cnlohr/magfestbadges/README.md

magfestbadges
=============

The codebase, schematics, etc. of the MAGFest Badges.
