cnlohr/magfestbadges/hardware/BoardAndTop.pdf

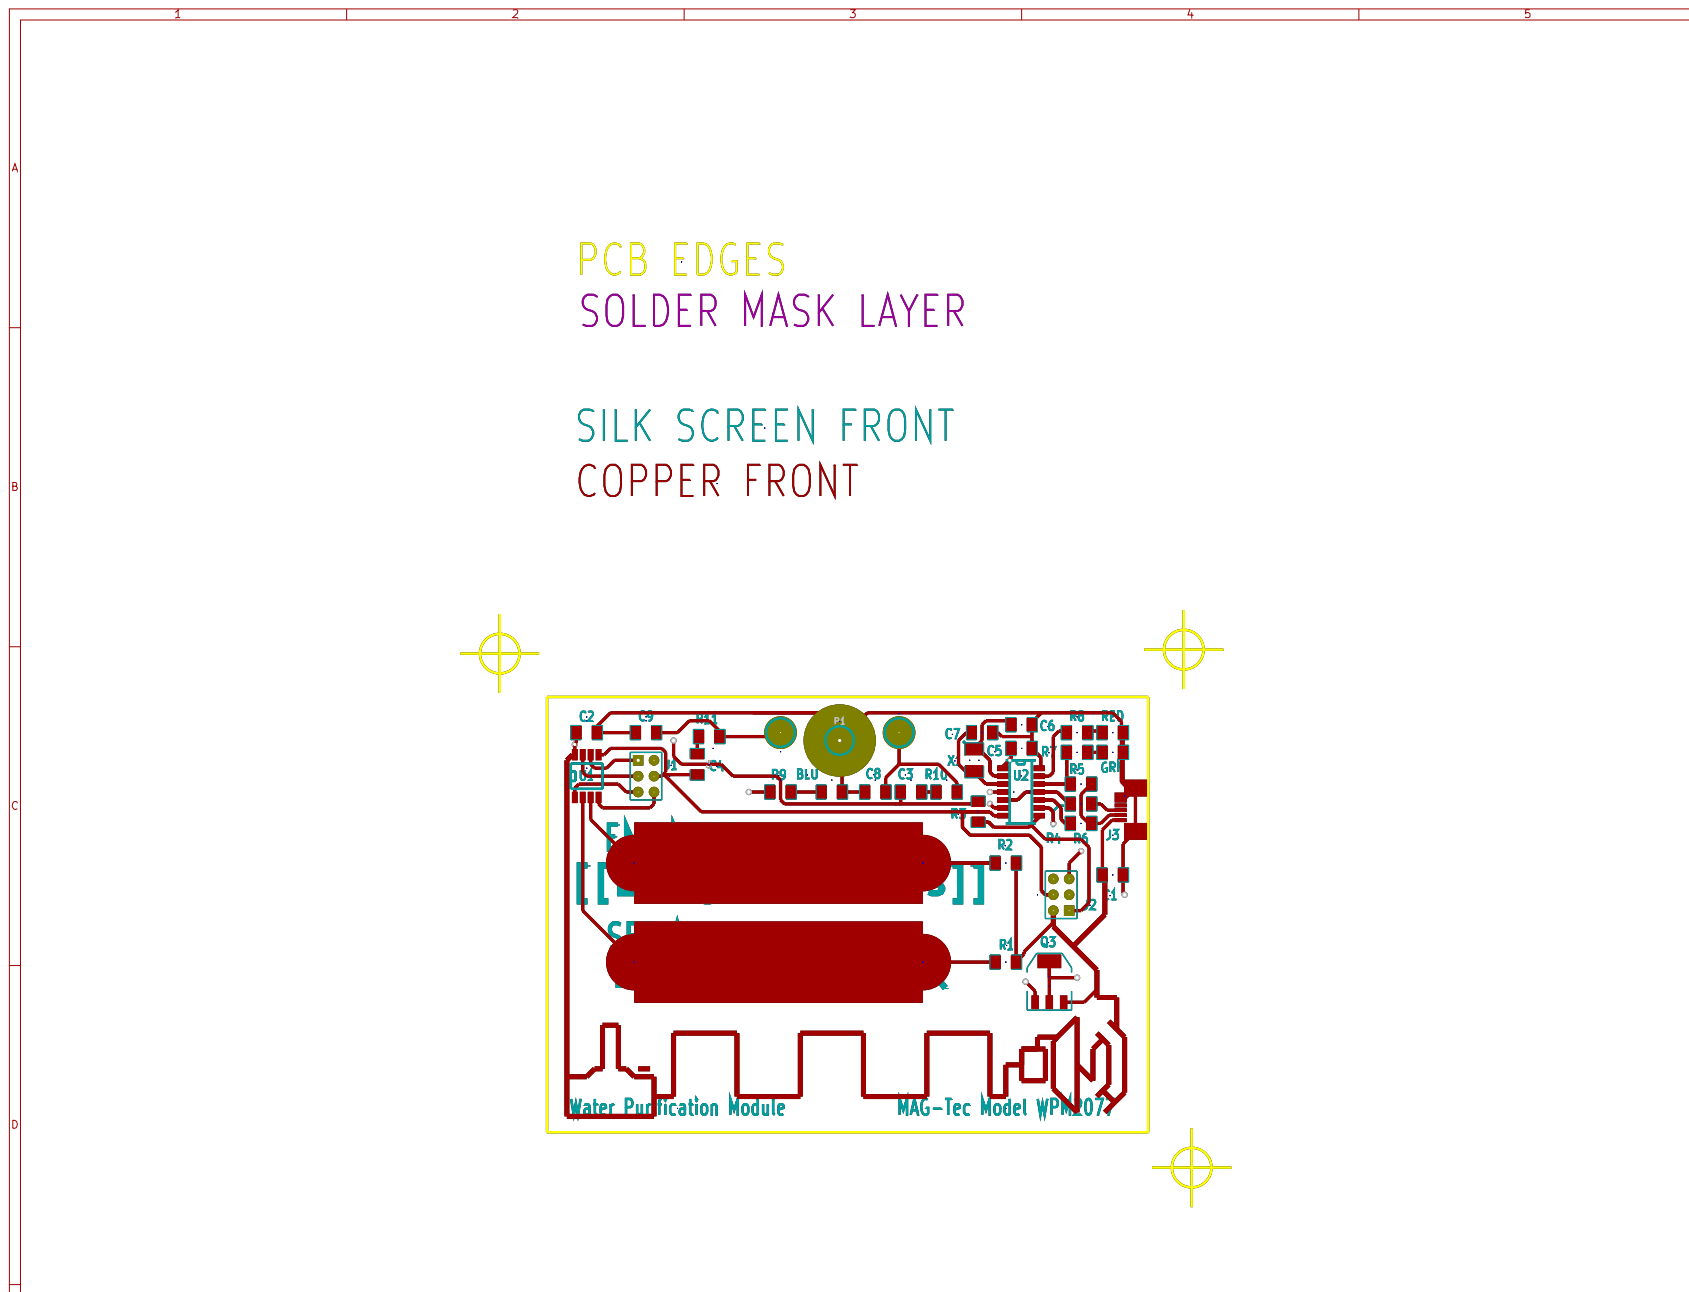
[picture p1: page 1]
