cnlohr/magfestbadges/hardware/schematic.pdf

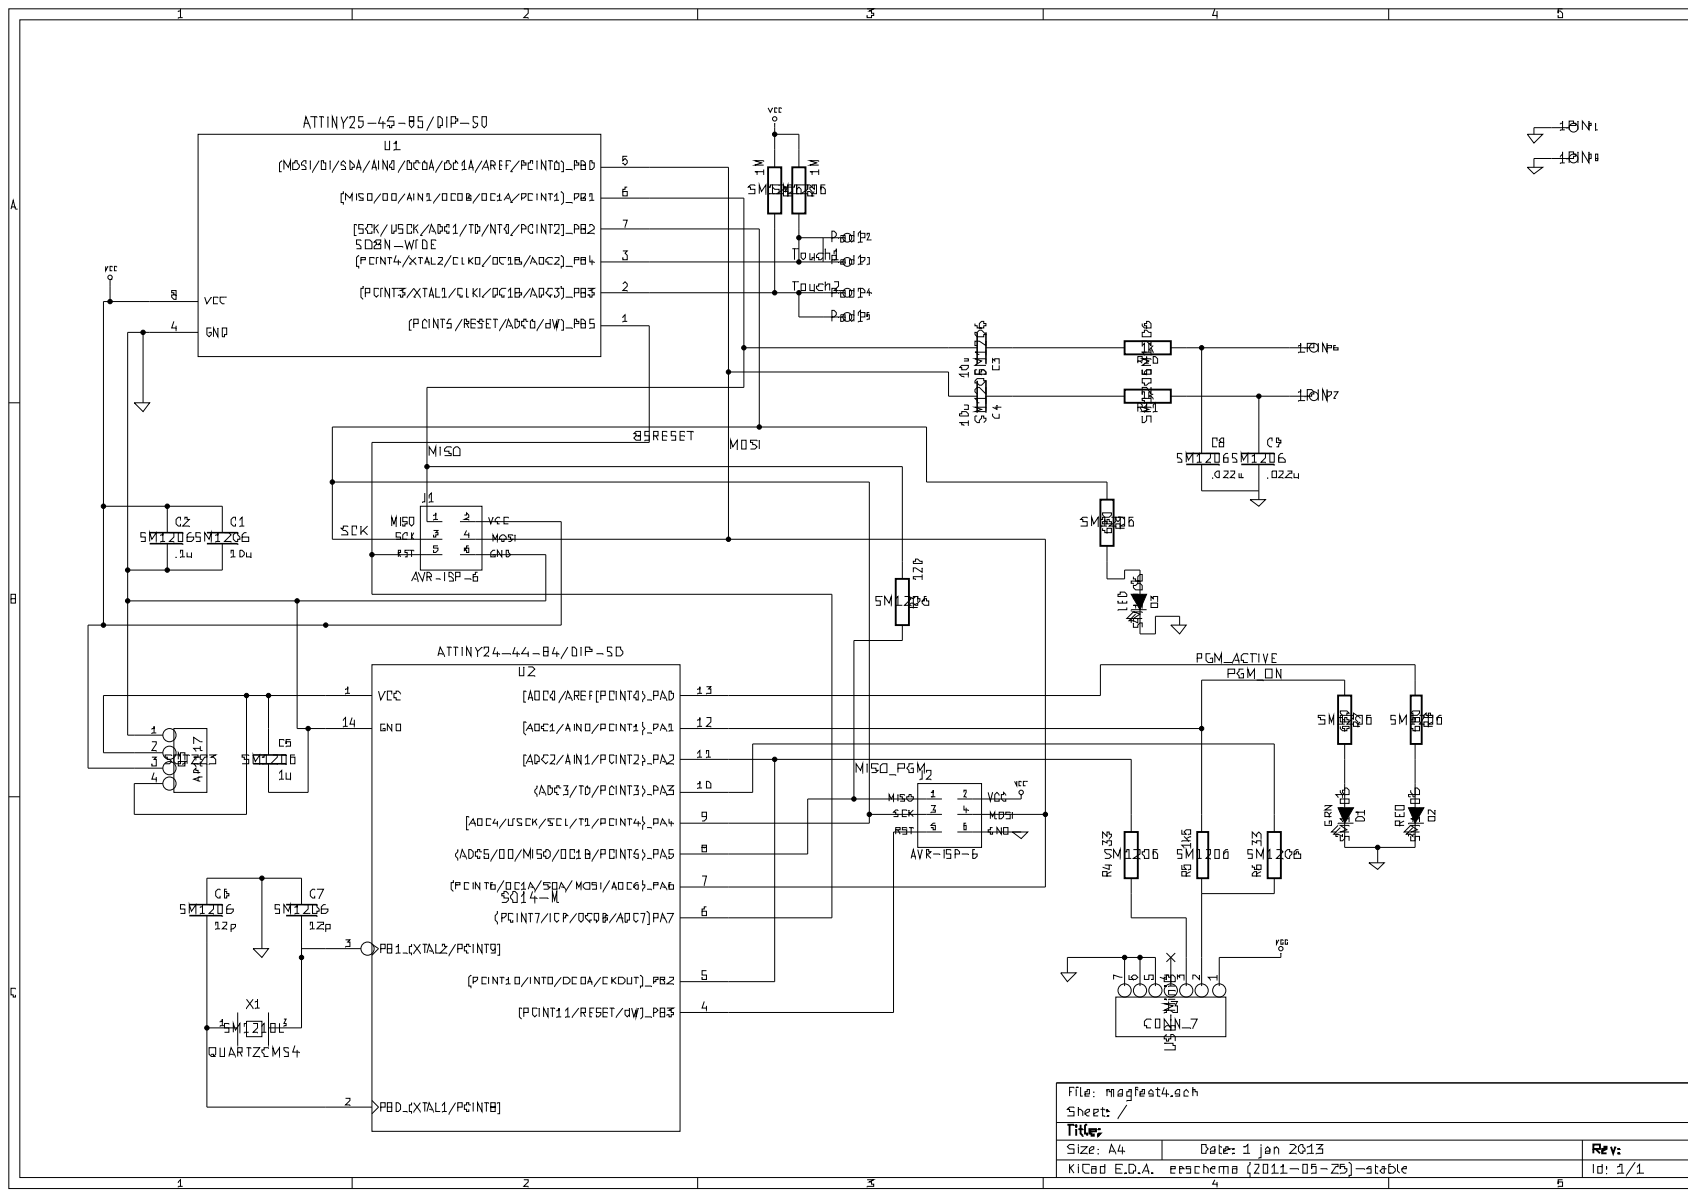
[picture p2: page 1]
