cnlohr/magfestbadges/hardware/magfest4.sch

## KiCad design hardware/magfest4.sch (2013-01-05)

Schematic: magfest4.sch

Parts:
C1, C3, C4: 10u; SM1206
C2: .1u; SM1206
C5: 1u; SM1206
C6, C7: 12p; SM1206
C8, C9: .022u; SM1206
D1: GRN; SM1206
D2: RED; SM1206
D3: LED; SM1206
J1, J2: AVR-ISP-6; pin_array_3x2
J3: CONN_7; USB-MiniB
P1, P6, P7, P8: CONN_1; 1PIN
P2, P3, P4, P5: CONN_1; Pad1
Q3: AP1117; SOT223
R1, R2: 1M; SM1206
R3: 120; SM1206
R4, R6: 33; SM1206
R5: 1k5; SM1206
R7, R8, R9: 680; SM1206
R10, R11: 1k; SM1206
U1: ATTINY25-45-85/DIP-SO; SO8N-WIDE
U2: ATTINY24-44-84/DIP-SO; SO14-M
X1: QUARTZCMS4; SM1210L
