cnlohr/magfestbadges/programmerfw/spi/main.c

// ======================================================================
// Control a parallel port AVR programmer (avrdude type "bsd") via USB.
//
// Copyright (C) 2006 Dick Streefland
//
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
#include <avr/io.h>
#include "usb.h"

enum
{
	// Generic requests
	USBTINY_ECHO,		// echo test
	USBTINY_READ,		// read byte
	USBTINY_WRITE,		// write byte
	USBTINY_CLR,		// clear bit 
	USBTINY_SET,		// set bit
	// Programming requests
	USBTINY_POWERUP,	// apply power (wValue:SCK-period, wIndex:RESET)
	USBTINY_POWERDOWN,	// remove power from chip
	USBTINY_SPI,		// issue SPI command (wValue:c1c0, wIndex:c3c2)
	USBTINY_POLL_BYTES,	// set poll bytes for write (wValue:p1p2)
	USBTINY_FLASH_READ,	// read flash (wIndex:address)
	USBTINY_FLASH_WRITE,	// write flash (wIndex:address, wValue:timeout)
	USBTINY_EEPROM_READ,	// read eeprom (wIndex:address)
	USBTINY_EEPROM_WRITE,	// write eeprom (wIndex:address, wValue:timeout)
	USBTINY_DDRWRITE,        // set port direction
	USBTINY_SPI1            // a single SPI command
};

// ----------------------------------------------------------------------
// Programmer output pins:
//	LED	PB0	(D0)
#define LED PA0
#define POWER_PULLUP	PA1
//	VCC	PB1	(D1)
//	VCC	PB2	(D2)
//	VCC	PB3	(D3)
//	RESET	PB5	(D4)
#define RESET PA7
//	MOSI	PB5	(D5)
#define MOSI  PA6
//	SCK	PB7	(D7)
#define SCK   PA4

// ----------------------------------------------------------------------
#define	PORT		PORTA
#define	DDR		DDRA
#define	POWER_MASK	_BV(POWER_PULLUP)
#define	RESET_MASK	_BV(RESET)
#define	SCK_MASK	_BV(SCK)
#define	MOSI_MASK	_BV(MOSI)
#define LED_MASK        _BV(LED)

// ----------------------------------------------------------------------
// Programmer input pins:
//	MISO	PA6
#define MISO       5
// ----------------------------------------------------------------------
#define	PIN		PINA
#define	MISO_MASK	_BV(MISO)

// ----------------------------------------------------------------------
// Local data
// ----------------------------------------------------------------------
static	byte_t		sck_period;	// SCK period in microseconds (1..250)
static	byte_t		poll1;		// first poll byte for write
static	byte_t		poll2;		// second poll byte for write
static	uint_t		address;	// read/write address
static	uint_t		timeout;	// write timeout in usec
static	byte_t		cmd0;		// current read/write command byte
static	byte_t		cmd[4];		// SPI command buffer
static	byte_t		res[4];		// SPI result buffer

// ----------------------------------------------------------------------
// Delay exactly <sck_period> times 0.5 microseconds (6 cycles).
// ----------------------------------------------------------------------
__attribute__((always_inline))
static	void	delay ( void )
{
	asm volatile(
		"	mov	__tmp_reg__,%0	\n"
		"0:	rjmp	1f		\n"
		"1:	nop			\n"
		"	dec	__tmp_reg__	\n"
		"	brne	0b		\n"
		: : "r" (sck_period) );
}

// ----------------------------------------------------------------------
// Issue one SPI command.
// ----------------------------------------------------------------------
static	void	spi ( byte_t* cmd, byte_t* res, int i )
{
	byte_t	c;
	byte_t	r;
	byte_t	mask;

	while (i != 0)
	{
	  i--;
		c = *cmd++;
		r = 0;
		for	( mask = 0x80; mask; mask >>= 1 )
		{
			if	( c & mask )
			{
				PORT |= MOSI_MASK;
			}
			delay();
			PORT |= SCK_MASK;
			delay();
			r <<= 1;
			if	( PIN & MISO_MASK )
			{
				r++;
			}
			PORT &= ~ MOSI_MASK;
			PORT &= ~ SCK_MASK;
		}
		*res++ = r;
	}
}

// ----------------------------------------------------------------------
// Create and issue a read or write SPI command.
// ----------------------------------------------------------------------
static	void	spi_rw ( void )
{
	uint_t	a;

	a = address++;
	if	( cmd0 & 0x80 )
	{	// eeprom
		a <<= 1;
	}
	cmd[0] = cmd0;
	if	( a & 1 )
	{
		cmd[0] |= 0x08;
	}
	cmd[1] = a >> 9;
	cmd[2] = a >> 1;
	spi( cmd, res, 4 );
}

unsigned char micro_remap_mask( unsigned char c )
{
	unsigned char outmask = POWER_MASK;
	if( c & 1 )	outmask |= LED_MASK;
	if( c & 16 )	outmask |= RESET_MASK;
	if( c & 32 )	outmask |= MOSI_MASK;
	if( c & 64 )	outmask |= MISO_MASK;
	if( c & 128 )	outmask |= SCK_MASK;
	return outmask;
}

// ----------------------------------------------------------------------
// Handle a non-standard SETUP packet.
// ----------------------------------------------------------------------
extern	byte_t	usb_setup ( byte_t data[8] )
{
	byte_t	bit;
	byte_t	mask;
	byte_t*	addr;
	byte_t	req;

	// Generic requests
	req = data[1];
	if	( req == USBTINY_ECHO )
	{
		return 8;
	}
	addr = (byte_t*) (int) data[4];
	bit = data[2] & 7;

	mask = 1 << bit;
	if (req == USBTINY_SET) {
	  mask = micro_remap_mask( mask );
	  PORT |= mask | POWER_MASK;
	  return 0;
	}
	if (req == USBTINY_CLR) {
	  mask = micro_remap_mask( mask );
	  PORT &= (~ mask) | POWER_MASK;
	  return 0;
	}
	if (req == USBTINY_WRITE) {
	  mask = micro_remap_mask( data[2] );
	  PORT = mask | POWER_MASK;
	  return 0;
	}
	if (req == USBTINY_READ) {
	  data[0] = PIN;
	  return 1;
	}
	if (req == USBTINY_DDRWRITE) {
	  mask = micro_remap_mask( data[2] );
	  DDR = mask | _BV(POWER_PULLUP);
	}
	// Programming requests
	if	( req == USBTINY_POWERUP )
	{
		sck_period = data[2];
		PORT &= ~LED_MASK; DDR |= LED_MASK;
		mask = POWER_MASK;
		if	( data[4] )
		{
			mask |= RESET_MASK;
		}
//XXX		PORTD &= ~_BV(4); WAS BUFFEN
		DDR  = POWER_MASK | RESET_MASK | SCK_MASK | MOSI_MASK;
		PORT = mask;
		return 0;
	}
	if	( req == USBTINY_POWERDOWN )
	{
		PORT &= ~LED_MASK; DDR |= LED_MASK;
	  //PORT |= RESET_MASK;
		DDR  = 0x00 | POWER_MASK;
		PORT = 0x00 | POWER_MASK;
//XXX		PORTD |= _BV(4); WAS BUFFEN
		return 0;
	}
	if	( ! PORT )
	{
		return 0;
	}
	if	( req == USBTINY_SPI )
	{
	  spi( data + 2, data + 0, 4 );
		return 4;
	}
	if	( req == USBTINY_SPI1 )
	{
	  spi( data + 2, data + 0, 1 );
		return 1;
	}
	if	( req == USBTINY_POLL_BYTES )
	{
		poll1 = data[2];
		poll2 = data[3];
		return 0;
	}
	address = * (uint_t*) & data[4];
	if	( req == USBTINY_FLASH_READ )
	{
		cmd0 = 0x20;
		PORT |= LED_MASK;  DDR |= LED_MASK;
		return 0xff;	// usb_in() will be called to get the data
	}
	if	( req == USBTINY_EEPROM_READ )
	{
		cmd0 = 0xa0;
		PORT |= LED_MASK;  DDR |= LED_MASK;
		return 0xff;	// usb_in() will be called to get the data
	}
	timeout = * (uint_t*) & data[2];
	if	( req == USBTINY_FLASH_WRITE )
	{
		cmd0 = 0x40;
		PORT |= LED_MASK; DDR |= LED_MASK;
		return 0;	// data will be received by usb_out()
	}
	if	( req == USBTINY_EEPROM_WRITE )
	{
		cmd0 = 0xc0;
		PORT |= LED_MASK; DDR |= LED_MASK;
		return 0;	// data will be received by usb_out()
	}
	return 0;
}

// ----------------------------------------------------------------------
// Handle an IN packet.
// ----------------------------------------------------------------------
extern	byte_t	usb_in ( byte_t* data, byte_t len )
{
	byte_t	i;

	for	( i = 0; i < len; i++ )
	{
		spi_rw();
		data[i] = res[3];
	}
	return len;
}

// ----------------------------------------------------------------------
// Handle an OUT packet.
// ----------------------------------------------------------------------
extern	void	usb_out ( byte_t* data, byte_t len )
{
	byte_t	i;
	uint_t	usec;
	byte_t	r;

	for	( i = 0; i < len; i++ )
	{
		cmd[3] = data[i];
		spi_rw();
		cmd[0] ^= 0x60;	// turn write into read
		for	( usec = 0; usec < timeout; usec += 32 * sck_period )
		{	// when timeout > 0, poll until byte is written
		  spi( cmd, res, 4 );
			r = res[3];
			if	( r == cmd[3] && r != poll1 && r != poll2 )
			{
				break;
			}
		}
	}
}

// ----------------------------------------------------------------------
// Main
// ----------------------------------------------------------------------
__attribute__((naked))		// suppress redundant SP initialization
extern	int	main ( void )
{
//  PORTD |= _BV(4);
//  DDRA = _BV(6) | _BV(5) | _BV(4); // setup USB pullup, LED pin and buffer select pins to output
//  PORTD = _BV(6) | _BV(4); // pull pull-up and buffer disable high

	DDRA = _BV(LED) | _BV(POWER_PULLUP); //LED and USB Pullup 
	PORT = _BV(POWER_PULLUP); //Pullup only.

	usb_init();

  for	( ;; )
    {
      usb_poll();
    }
  return 0;
}
