cnlohr/magfestbadges/(commit log)

2013-01-05 add hardware
    [magfest4.brd, magfest4.sch]
2013-01-05 Add all the extra braches
    [ir.sch]
2013-01-05 update the BOM
