cnlohr/magfestbadges/(notices)

Notices in the files:
programmerfw/spi/usbtiny.h:
This is free software, licensed under the terms of the GNU General
